Fabiancrg/Aeris_zb/PCB/aeris/aeris.kicad_sch

## KiCad design PCB/aeris/aeris.kicad_sch (2025-11-17)

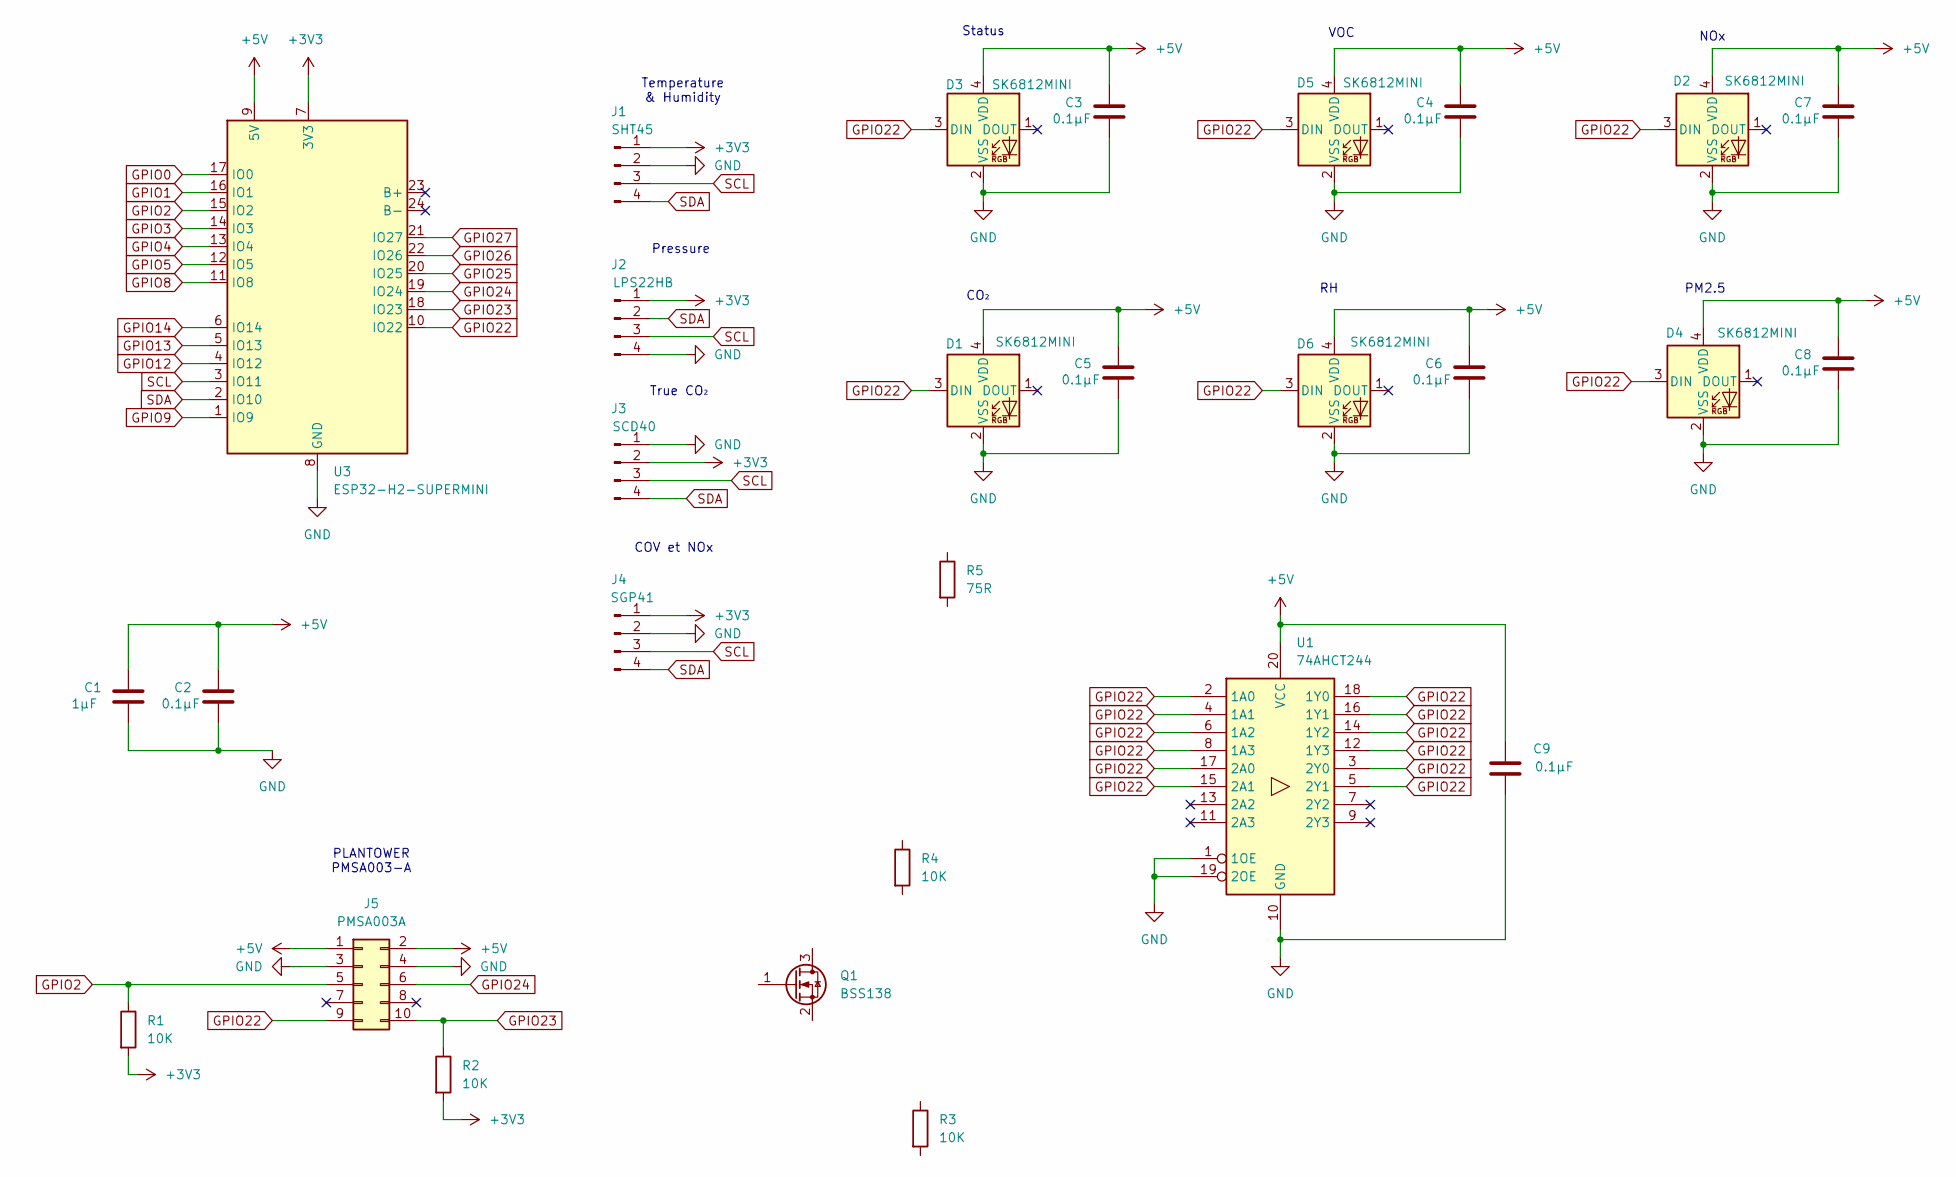
[picture p1: schematic aeris.kicad_sch]

Parts:
C1: 1µF; C_1206_3216Metric
C2, C3, C4, C5, C6, C7, C8, C9: 0.1µF; C_1206_3216Metric
D1, D2, D3, D4, D5, D6: SK6812MINI; LED_SK6812MINI_PLCC4_3.5x3.5mm_P1.75mm
J1: SHT45; PinHeader_1x04_P2.54mm_Vertical
J2: LPS22HB; PinHeader_1x04_P2.54mm_Vertical
J3: SCD40; PinHeader_1x04_P2.54mm_Vertical
J4: SGP41; PinHeader_1x04_P2.54mm_Vertical
J5: PMSA003A
Q1: BSS138; SOT-23
R1, R2, R3, R4: 10K
R5: 75R
U1: 74AHCT244
U3: ESP32-H2-SUPERMINI; ESP32H2-Supermini

Connections:
+3V3: J1.1, J2.1, J3.2, J4.1, R1.2, R2.2, U3.7 (3V3)
+5V: C1.1, C2.1, C3.1, C4.1, C5.1, C6.1, C7.1, C8.1, C9.1, D1.4 (VDD), D2.4 (VDD), D3.4 (VDD), D4.4 (VDD), D5.4 (VDD), D6.4 (VDD), J5.1, J5.2, U1.20 (VCC), U3.9 (5V)
GND: C1.2, C2.2, C3.2, C4.2, C5.2, C6.2, C7.2, C8.2, C9.2, D1.2 (VSS), D2.2 (VSS), D3.2 (VSS), D4.2 (VSS), D5.2 (VSS), D6.2 (VSS), J1.2, J2.4, J3.1, J4.2, J5.3, J5.4, U1.1 (1OE), U1.10 (GND), U1.19 (2OE), U3.8 (GND)
GPIO0: U3.17 (IO0)
GPIO1: U3.16 (IO1)
GPIO2: J5.5, R1.1, U3.15 (IO2)
GPIO3: U3.14 (IO3)
GPIO4: U3.13 (IO4)
GPIO5: U3.12 (IO5)
GPIO8: U3.11 (IO8)
GPIO9: U3.1 (IO9)
GPIO12: U3.4 (IO12)
GPIO13: U3.5 (IO13)
GPIO14: U3.6 (IO14)
GPIO22: D1.3 (DIN), D2.3 (DIN), D3.3 (DIN), D4.3 (DIN), D5.3 (DIN), D6.3 (DIN), J5.9, U1.2 (1A0), U1.3 (2Y0), U1.4 (1A1), U1.5 (2Y1), U1.6 (1A2), U1.8 (1A3), U1.12 (1Y3), U1.14 (1Y2), U1.15 (2A1), U1.16 (1Y1), U1.17 (2A0), U1.18 (1Y0), U3.10 (IO22)
GPIO23: J5.10, R2.1, U3.18 (IO23)
GPIO24: J5.6, U3.19 (IO24)
GPIO25: U3.20 (IO25)
GPIO26: U3.22 (IO26)
GPIO27: U3.21 (IO27)
SCL: J1.3, J2.3, J3.3, J4.3, U3.3 (IO11)
SDA: J1.4, J2.2, J3.4, J4.4, U3.2 (IO10)

Notes on the sheet:
Status
VOC
Pressure
True CO₂
Temperature & Humidity
CO₂
PM2.5
PLANTOWER PMSA003-A
NOx
COV et NOx
