Fabiancrg/Aeris_zb/(commit log)

2025-11-03 Rename hvac -> aeris: driver and esp_zb files
2025-11-03 Add LPS22HB pressure sensor support and update driver initialization
2025-11-04 Refactor README and driver files for Zigbee Air Quality Sensor
    - Updated README.md to reflect the new project focus on air quality sensing, including hardware requirements, features, and sensor configurations.
    - Removed outdated README_HVAC.md file.
    - Enhanced aeris_driver.c with initialization and reading functions for the SHT45 temperature and humidity sensor, including CRC checks and error handling.
    - Added SHT45 I2C address definition in aeris_driver.h.
    - Improved logging for sensor initialization and reading processes.
    [aeris_driver.c, aeris_driver.h]
2025-11-05 Refactor Zigbee sensor endpoints to include PM1.0, PM2.5, and PM10; update endpoint definitions and attribute updates accordingly
2025-11-05 feat: Add NOx Index sensor support and update endpoint configurations
2025-11-05 feat: Add NOx Index sensor support and update related configurations
2025-11-14 feat: Update project version to 1.0 and enhance temperature, humidity, pressure, and CO2 measurement clusters with reporting flags
2025-11-15 feat: Enhance PMSA003A task with buffer safety checks, UART error handling, and timer management improvements
    [aeris_driver.c, esp_zb_aeris.c, led_indicator.c]
2025-11-16 Update Doc + PCB (WIP)
    [aeris.kicad_sch]
2025-11-16 feat: Add PMSA003A sensor control pins and update documentation for power management
2025-11-16 Update PCB
    [aeris.kicad_sch]
2025-12-03 feat: Add temperature offset compensation for SHT45 sensor
    - Introduced a temperature offset variable to compensate for self-heating effects in the SHT45 sensor.
    - Updated the temperature reading function to apply the offset.
    - Added functions to set and get the temperature offset value.
    refactor: Clean up PMSA003A polling logic
    - Removed unnecessary wake time reset logic after successful data read.
    - Simplified logging during driver initialization.
    fix: Update GPIO configurations for LED and PMSA003A control
    - Changed GPIO pin assignments for humidity LED and PMSA003A sleep/wake control.
    chore: Remove WiFi logging functionality
    - Deleted WiFi logging implementation files and reference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
    [partitions.csv]
2025-12-03 feat: Update PMSA003A sensor initialization to control sleep state and trigger immediate readings
2025-12-04 FIx issue with One-shot mode for presure sensore, revert back to continuous mode
    [aeris_driver.c, esp_zb_aeris.c]
2025-12-09 refactor: Update SHT45 command definitions to redue self heating
